warhog/grillee/doc/sensor_pro05/README.md

Measurement data for PRO-05 probe types (e.g. https://www.amazon.de/Grillthermometer-TOPELEK-Ofenthermometer-Hintergrundbeleuchtung-Montagedesign/dp/B074M9D9M4, probe only: https://www.amazon.de/gp/product/B07F3X22DY/ref=ppx_yo_dt_b_search_asin_title?ie=UTF8&psc=1)

Script (wlt_2_fit.py) taken from https://github.com/BjoernSch/WLANThermo_fit/
