warhog/grillee/grillee-app/resources/grillee-auto-2.svg.png

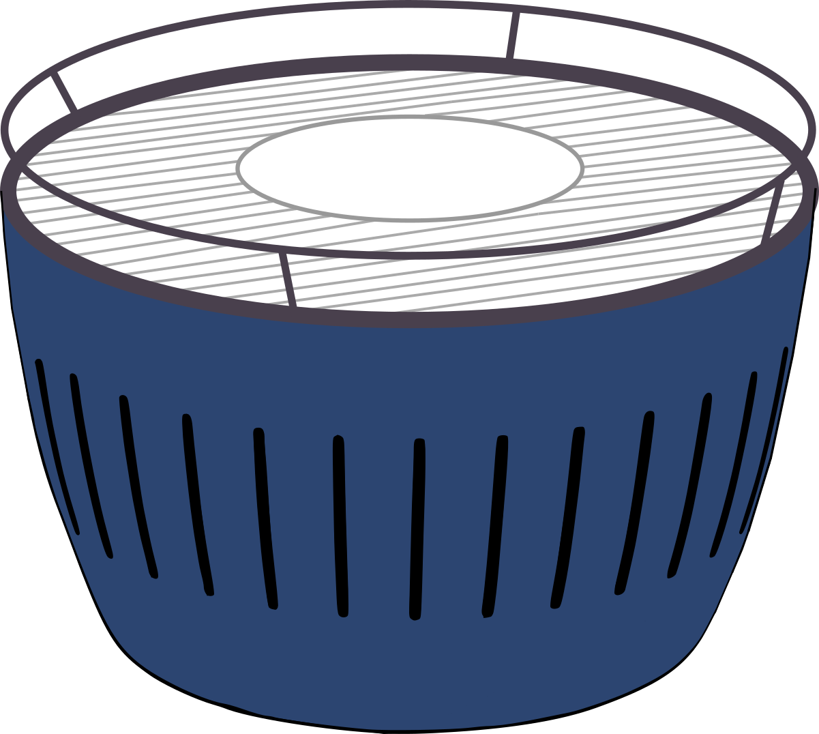
grillee-app/resources/grillee-auto-2.svg.png
