warhog/grillee/grillee-app/src/assets/images/flag-language-en.png

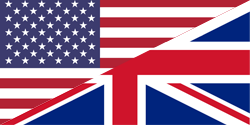
grillee-app/src/assets/images/flag-language-en.png
