warhog/grillee/hardware/schematics.pdf

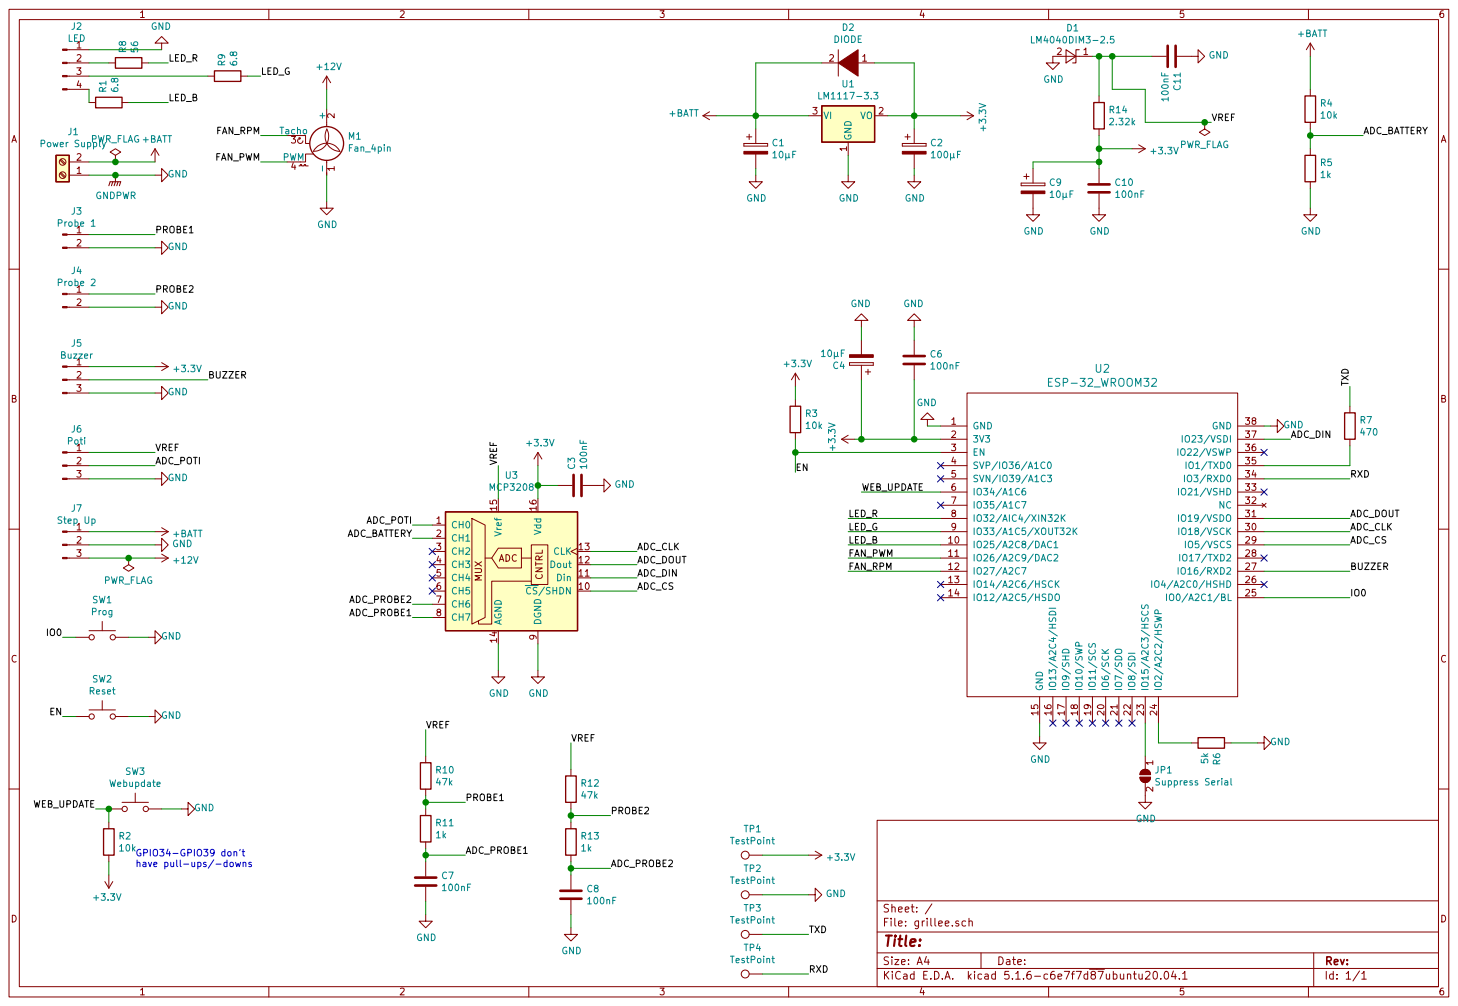
[picture p5: page 1]

TP2 TestPoint TP3 TestPoint TP4 TestPoint TP1 TestPoint

GPIO34-GPIO39 don't have pull-ups/-downs

File: grillee.sch Sheet: /
Id: 1/1 Title:
