warhog/grillee/hardware/grillee.kicad_pcb

## KiCad design hardware/grillee.kicad_pcb (2020-08-30)

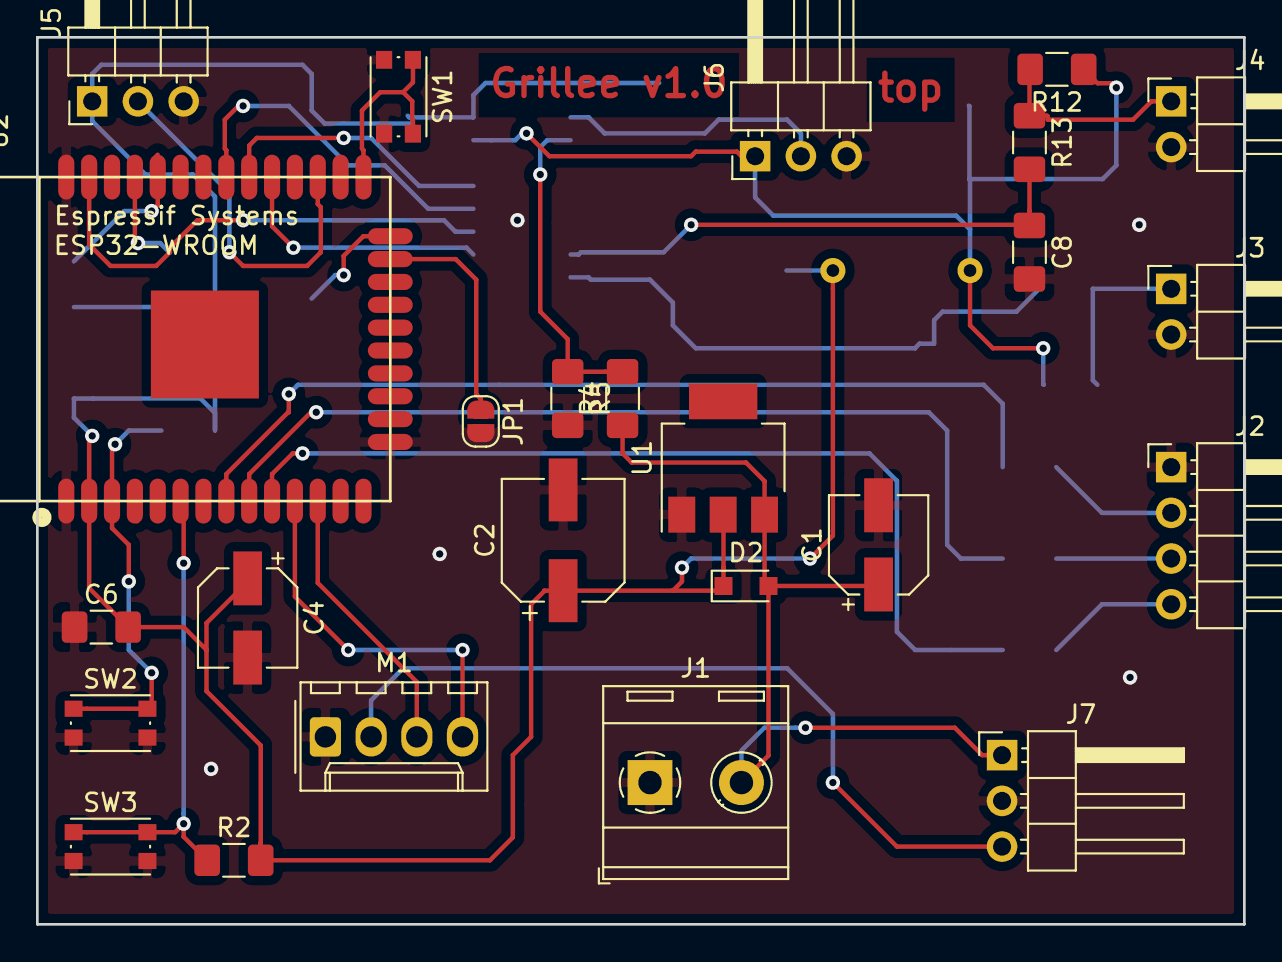
[picture p6: board grillee.kicad_pcb from above]

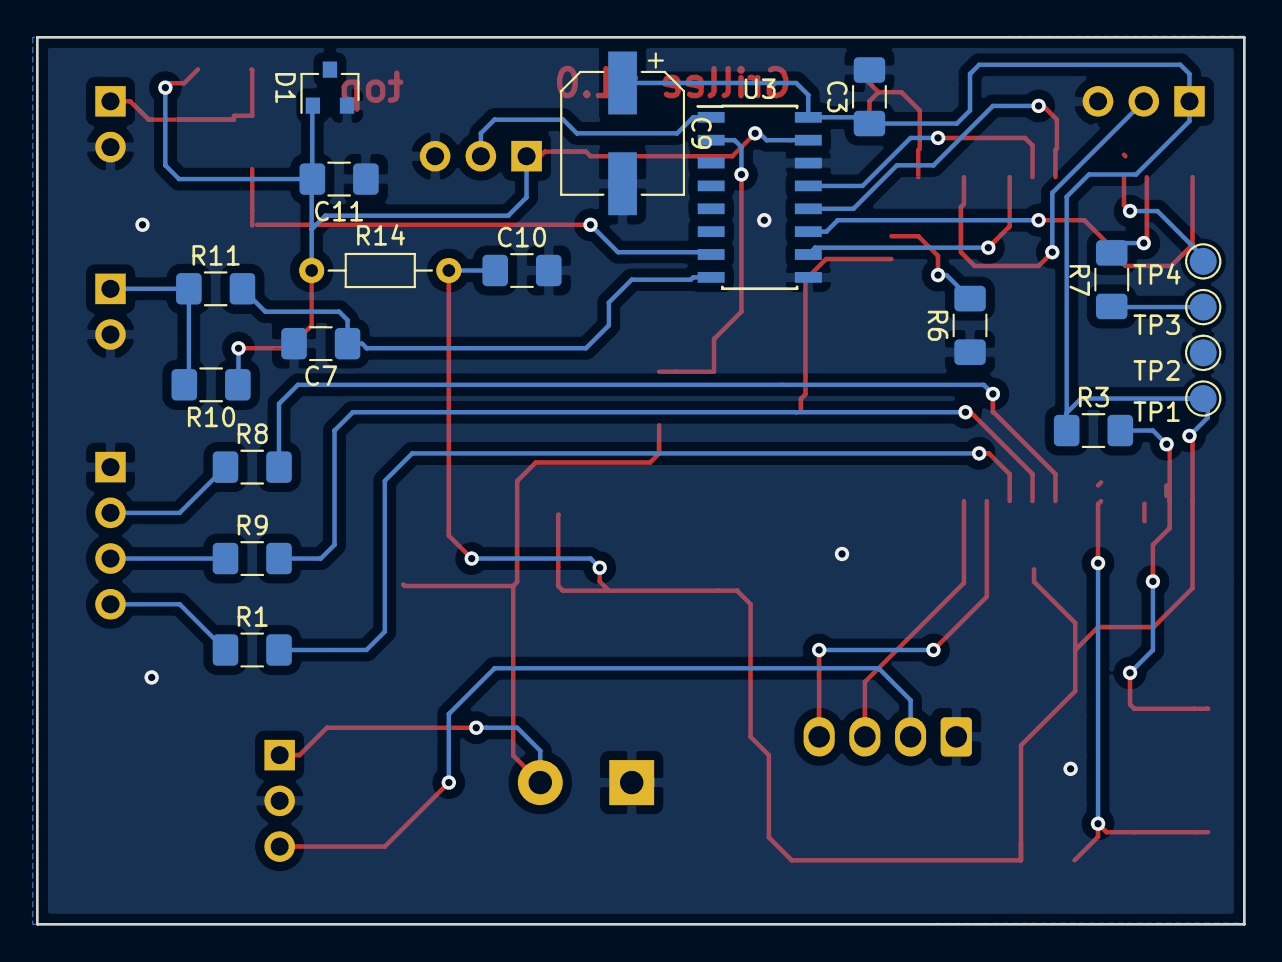
[picture p7: board grillee.kicad_pcb from below]

Board: 2 copper layers, 67.1 x 49.3 mm, 45 parts (20 on the bottom side), 32 nets.

Parts:
C1, C4: 10µF; CP_Elec_5x4.4
C2: 100µF; CP_Elec_6.3x5.4
C3, C6, C7, C8, C10, C11: 100nF; C_1206_3216Metric_Pad1.42x1.75mm_HandSolder
C9: 10µF; CP_Elec_6.3x5.4
D1: LM4040DIM3-2.5; SOT-23
D2: DIODE; D_SOD-323_HandSoldering
J1: Power Supply; TerminalBlock_RND_205-00287_1x02_P5.08mm_Horizontal
J2: LED; PinHeader_1x04_P2.54mm_Horizontal
J3: Probe 1; PinHeader_1x02_P2.54mm_Horizontal
J4: Probe 2; PinHeader_1x02_P2.54mm_Horizontal
J5: Buzzer; PinHeader_1x03_P2.54mm_Horizontal
J6: Poti; PinHeader_1x03_P2.54mm_Horizontal
J7: Step Up; PinHeader_1x03_P2.54mm_Horizontal
JP1: Suppress Serial; SolderJumper-2_P1.3mm_Open_RoundedPad1.0x1.5mm
M1: Fan_4pin; Molex_KK-254_AE-6410-04A_1x04_P2.54mm_Vertical
R1, R9: 6.8; R_1206_3216Metric_Pad1.42x1.75mm_HandSolder
R2, R3, R4: 10k; R_1206_3216Metric_Pad1.42x1.75mm_HandSolder
R5, R11, R13: 1k; R_1206_3216Metric_Pad1.42x1.75mm_HandSolder
R6: 5k; R_1206_3216Metric_Pad1.42x1.75mm_HandSolder
R7: 470; R_1206_3216Metric_Pad1.42x1.75mm_HandSolder
R8: 56; R_1206_3216Metric_Pad1.42x1.75mm_HandSolder
R10, R12: 47k; R_1206_3216Metric_Pad1.42x1.75mm_HandSolder
R14: 2.32k; R_Axial_DIN0204_L3.6mm_D1.6mm_P7.62mm_Horizontal
SW1: Prog; SW_SPST_KMR2
SW2: Reset; SW_SPST_KMR2
SW3: Webupdate; SW_SPST_KMR2
TP1, TP2, TP3, TP4: TestPoint; TestPoint_Pad_D1.5mm
U1: LM1117-3.3; SOT-223
U2: ESP-32_WROOM32; ESP32-WROOM
U3: MCP3208; SOIC-16_3.9x9.9mm_P1.27mm

Connections:
+3V3: C2.1, C3.1, C4.1, C6.2, C9.1, C10.1, D2.1, J5.1, R2.2, R3.1, R14.2, TP1.1, U1.2, U2.2, U3.16
+12V: J7.3, M1.2
+BATT: C1.1, D2.2, J1.2, J7.1, R4.1, U1.3
/ADC_BATTERY: R4.2, R5.1, U3.2
/ADC_CLK: U2.30, U3.13
/ADC_CS: U2.29, U3.10
/ADC_DIN: U2.37, U3.11
/ADC_DOUT: U2.31, U3.12
/ADC_POTI: J6.2, U3.1
/ADC_PROBE1: C7.1, R11.2, U3.8
/ADC_PROBE2: C8.1, R13.2, U3.7
/BUZZER: J5.2, U2.27
/EN: R3.2, SW2.1, U2.3
/FAN_PWM: M1.4, U2.11
/FAN_RPM: M1.3, U2.12
/IO0: SW1.1, U2.25
/LED_B: R1.2, U2.10
/LED_G: R9.2, U2.9
/LED_R: R8.2, U2.8
/PROBE1: J3.1, R10.2, R11.1
/PROBE2: J4.1, R12.2, R13.1
/RXD: TP4.1, U2.34
/TXD: R7.1, TP3.1
/VREF: C11.2, D1.1, J6.1, R10.1, R12.1, R14.1, U3.15
/WEB_UPDATE: R2.1, SW3.1, U2.6
GND: C1.2, C2.2, C3.2, C4.2, C6.1, C7.2, C8.2, C9.2, C10.2, C11.1, D1.2, J1.1, J2.1, J3.2, J4.2, J5.3, J6.3, J7.2, JP1.2, M1.1, R5.2, R6.1, SW1.2, SW2.2, SW3.2, TP2.1, U1.1, U2.1, U2.15, U2.38, U3.9, U3.14
unnamed: J2.2, R8.1
unnamed: J2.3, R9.1
unnamed: J2.4, R1.1
unnamed: JP1.1, U2.23
unnamed: R6.2, U2.24
unnamed: R7.2, U2.35
