warhog/grillee/(commit log)

2020-05-06 working probes
    [data_curvefit.csv, data_report.csv, pro05.csv]
2020-05-13 lot of changes, fixed data transmission between device and app
    [data_curvefit.csv, data_report.csv, pro05 (copy).csv, pro05.csv, pro05_curvefit.csv, pro05_report.csv]
2020-05-13 lot of fixes and improvements
    [bleserver.h, sensortype.h]
2020-05-15 added mcp3208 adc, many improvements
2020-05-15 added first step of alarming, improvemetns and fixes
    [probe.h]
2020-05-16 improve buzzer sound, some bugfixes
    [buzzer.h, edgedetector.h, timeout.h]
2020-06-05 new pin layout, added datasheets
2020-08-02 fixed ledc pwm setup
    [buzzer.h, fan.h, led.h]
2020-08-02 change buzzer state order
    [buzzer.h]
2020-08-08 remove temperature printing to console
2020-08-14 fixed adc channel order, reordered ledc channels
    [battery.h, fan.h, ledc.h]
2020-08-15 added back button callback to suppress background mode on exit
2020-08-15 correct battery voltage divider comment
    [battery.h]
2020-08-22 fix adc, add led gamma correction
    [adc_mcp3208.h, battery.h, create_led_fade_tables.py, led.h, probe.h]
2020-08-22 added hardware stuff
    [lotusble-B_Cu.gbl, lotusble-B_Mask.gbs, lotusble-B_Paste.gbp, lotusble-B_SilkS.gbo, lotusble-Edge_Cuts.gm1, lotusble-F_Cu.gtl, lotusble-F_Mask.gts, lotusble-F_Paste.gtp]
2020-08-29 add storage of last selected probe temperature, add help texts
2020-08-29 added license headers, removed old adc, changed to medianfilterlib2, travis build improvements, splitted huge libs, improve led handling, some small fixes
    [adc_mcp3208.h, alarm.h, battery.h, bleserver.cpp, bleserver.h, buzzer.h, create_led_fade_tables.py, edgedetector.h]
2020-08-29 added readme for sensor data
2020-09-19 add arduinojson to travis build
